TomyDaniel/Digital2-Grupo8/(list of files, drawings)

Other design files:
hardware/TPFinal.pdsprj
