TomyDaniel/Digital2-Grupo8/(commit log)

2026-05-27 agrego documentación y código fuente del sistema de control de ascensor
2026-06-14 Add documentation, firmware, and hardware diagrams for temperature control project
    - Added SRD relay specification document (SRD.PDF) detailing features, applications, ratings, and performance.
    - Implemented firmware for PIC16F887 in assembly (Pava.asm) to manage temperature sensing, display multiplexing, relay control, and UART communication.
    - Included block diagram images (diagrama_bloques.png and diagrama_bloques.svg) illustrating the system architecture for the temperature control application.
2026-06-14 Remove outdated simulation guide for temperature control project
2026-06-16 Add schematic diagram and project file for temperature control system
    [TPFinal.pdsprj]
2026-06-17 Fix image formatting in README.md and update schematic diagram
